bmetk/IoT-Based-Industrial-Data-Collection_2026/3D-Models_Inherited/misc/mlx90614-module-2.snapshot.2/MLX90164_Option_Code_Zoom_Optimized.jpg

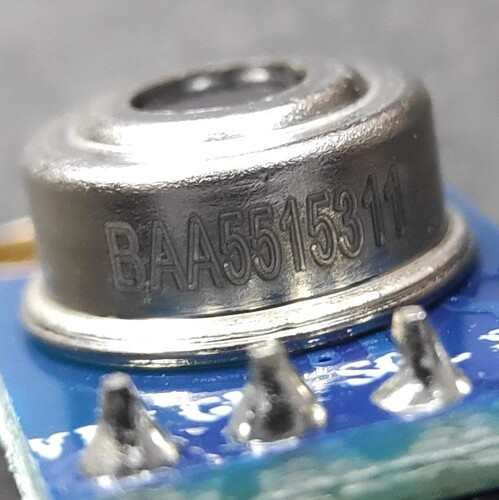
3D-Models_Inherited/misc/mlx90614-module-2.snapshot.2/MLX90164_Option_Code_Zoom_Optimized.jpg
