bmetk/IoT-Based-Industrial-Data-Collection_2026/README.md

# COMPACT-MAPS
Machine Analizator and Processor System
