bmetk/IoT-Based-Industrial-Data-Collection_2026/ESP_portkiosztasok.pdf

## ESP1 portkiosztása

ESP1 PORT | IR OPTO PORT
Bal felső 3V3 | IR opto VCC
Jobb felső GND | IR opto GND
GPIO 36 | IR opto OUT
ESP1 PORT | HŐMÉRŐ
Bal felső 3V3 | MLX VCC
Jobb felső GND | MLX GND
SCL – GPIO 22 | MLX SCL (közös)
SDA – GPIO 21 | MLX SDA (közös)
ESP1 PORT | ÁRAMMÉRŐ
Bal felső 3V3 | PHASE VCC
Jobb felső GND | PHASE GND
GPIO 32 | PHASE1_PIN
GPIO 33 | PHASE2_PIN
GPIO 35 | PHASE3_PIN
GPIO 34 | OFFSET_PIN
ESP1 PORT | KIJELZŐ
Bal felső 3V3 | SSD VCC
Jobb felső GND | SSD GND
SCL – GPIO 22 | SSD SCL (közös)
SDA – GPIO 21 | SSD SDA (közös)
ESP1 PORT | KOMMUNIKÁCIÓ
GPIO 19 | NEXT_PIN (gomb)
GPIO 18 | ENTER_PIN (gomb)
GPIO 16 | SERIAL_DATA_SEND
GPIO 17 | SERIAL_DATA_RECEIVE

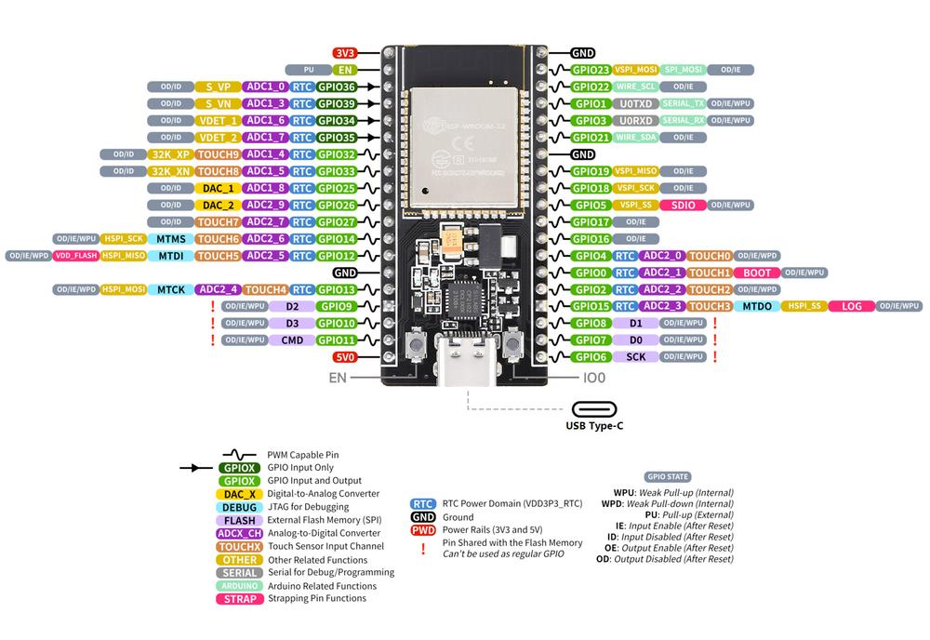
[picture p2: figure]

## ESP2 portkiosztása

ESP2 PORT | KOMMUNIKÁCIÓ
GPIO 17 | SERIAL_DATA_SEND
GPIO 16 | SERIAL_DATA_RECEIVE
ESP2 PORT | REZGÉSMÉRŐ
Bal felső 3V3 | MPU VCC
Jobb felső GND | MPU GND
SCL – GPIO 22 | MPU SCL
SDA – GPIO 21 | MPU SDA
GPIO 27 | MPU INT
