bmetk/IoT-Based-Industrial-Data-Collection_2026/3D-Models_Inherited/misc/mlx90614-module-2.snapshot.2/MLX90614XAA_Module_Angle_View_Bottom.jpg

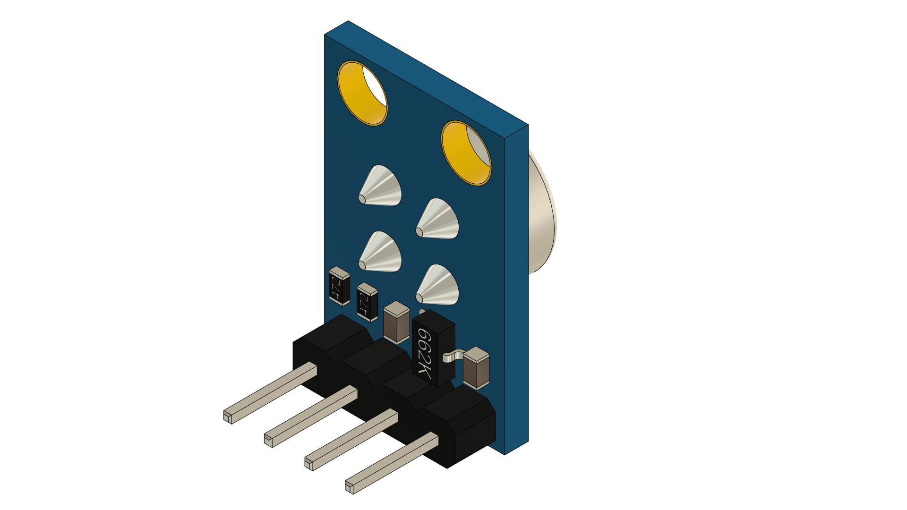
3D-Models_Inherited/misc/mlx90614-module-2.snapshot.2/MLX90614XAA_Module_Angle_View_Bottom.jpg
