bmetk/IoT-Based-Industrial-Data-Collection_2026/3D-Models_Inherited/3D printing/dust_cover.stl

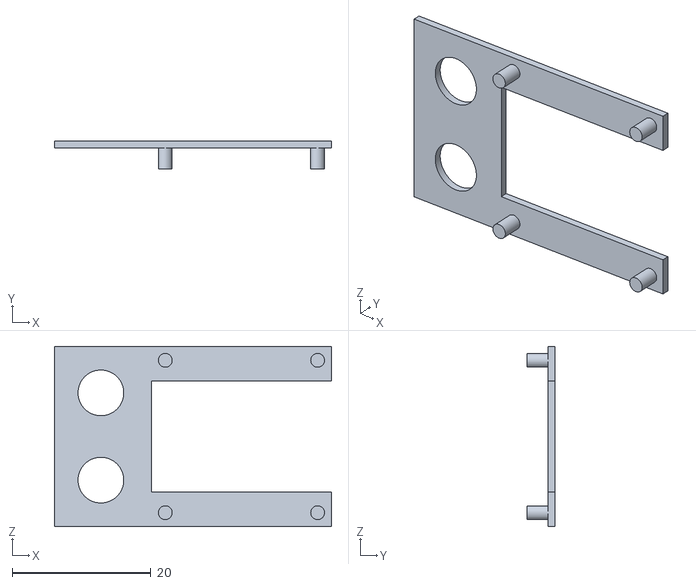
[picture p27: CAD file, 2026-06-04]
3D-Models_Inherited/3D printing/dust_cover.stl
40.0 x 4.00 x 26.0
