bmetk/IoT-Based-Industrial-Data-Collection_2026/3D-Models_Inherited/current sensor/current_sensor_cover.stl

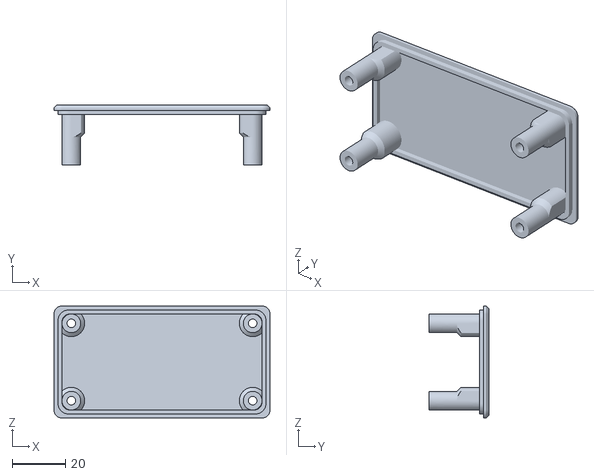
[picture p28: CAD file, 2026-05-20]
3D-Models_Inherited/current sensor/current_sensor_cover.stl
81.0 x 22.4 x 42.0
