bmetk/IoT-Based-Industrial-Data-Collection_2026/3D-Models_Inherited/EN3-01/disk_12_slot.stl

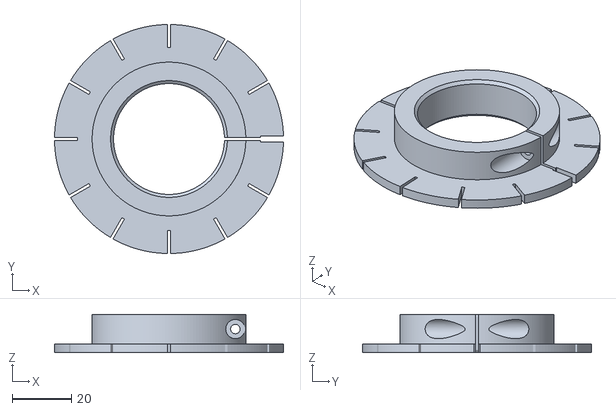
[picture p29: CAD file, 2026-06-04]
3D-Models_Inherited/EN3-01/disk_12_slot.stl
77.5 x 77.5 x 13.0
