bmetk/IoT-Based-Industrial-Data-Collection_2026/3D-Models_Inherited/housing/front_panel.stl

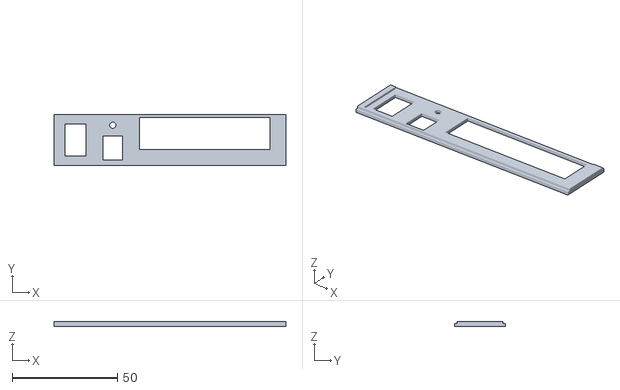
[picture p30: CAD file, 2026-06-04]
3D-Models_Inherited/housing/front_panel.stl
110.0 x 24.0 x 2.50
