bmetk/IoT-Based-Industrial-Data-Collection_2026/3D-Models_Inherited/housing/v_2/housing_top_v_2_2.stl

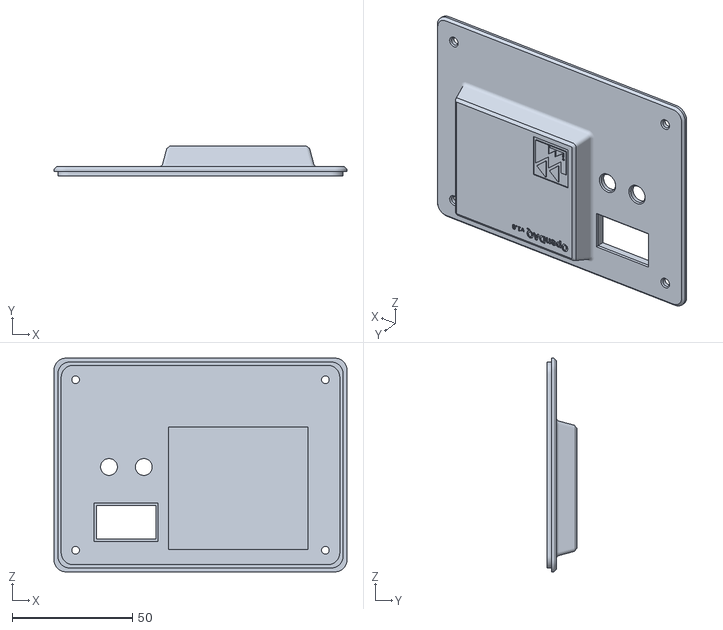
[picture p31: CAD file, 2026-06-04]
3D-Models_Inherited/housing/v_2/housing_top_v_2_2.stl
122.0 x 12.3 x 89.0
