bmetk/IoT-Based-Industrial-Data-Collection_2026/3D-Models_Inherited/misc/mlx_mount_4mm.stl

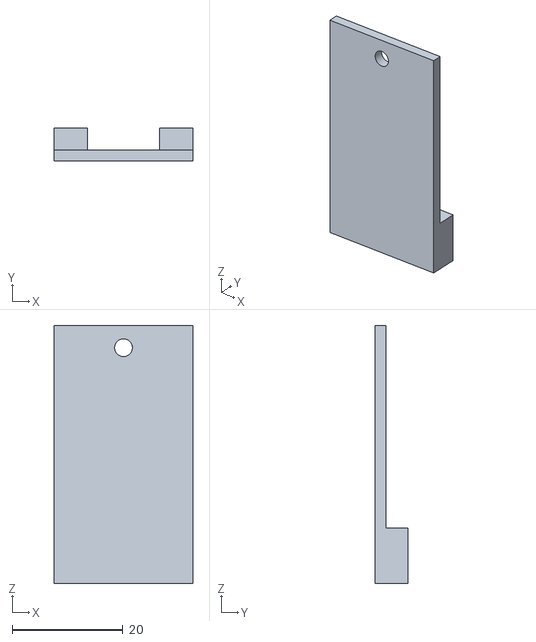
[picture p32: CAD file, 2026-06-04]
3D-Models_Inherited/misc/mlx_mount_4mm.stl
25.0 x 6.00 x 46.5
