bmetk/IoT-Based-Industrial-Data-Collection_2026/3D-Models_Reworked/housing_top_v_3 1.3mf

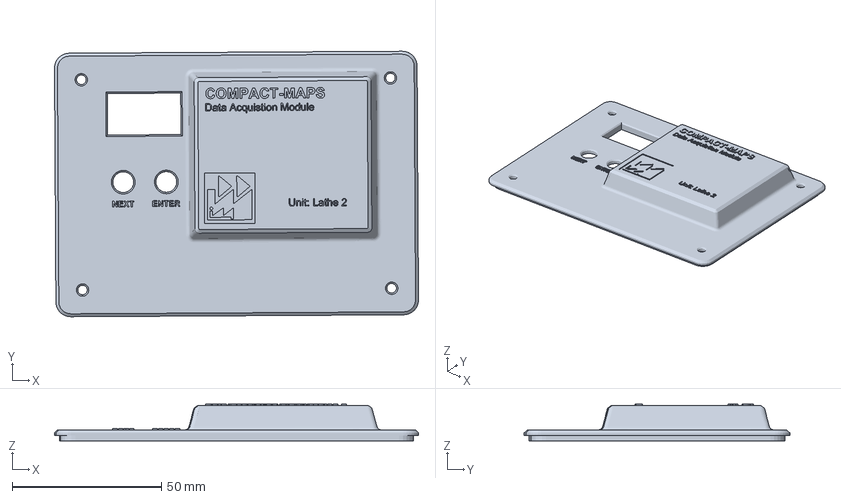
[picture p34: CAD file, 2026-05-20]
3D-Models_Reworked/housing_top_v_3 1.3mf
122.0 x 89.0 x 12.3 mm
