bmetk/IoT-Based-Industrial-Data-Collection_2026/Printed-Circuit-Boards_Inherited/resources/ZMCT103C/zmct103c.stp

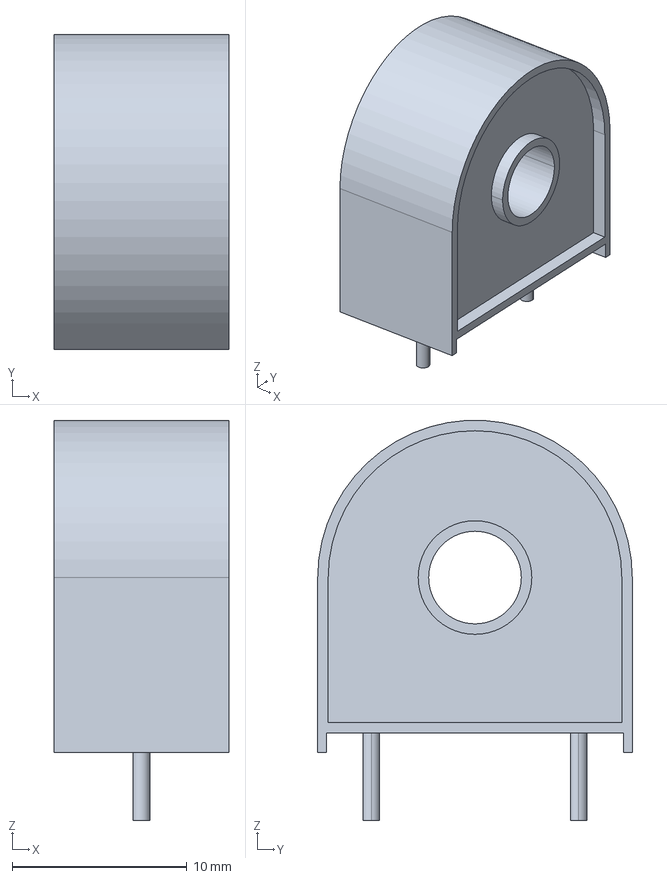
[picture p35: CAD file, 2026-06-04]
Printed-Circuit-Boards_Inherited/resources/ZMCT103C/zmct103c.stp
10.0 x 18.0 x 22.9 mm
