bmetk/IoT-Based-Industrial-Data-Collection_2026/Printed-Circuit-Boards_Inherited/zmct_3phase/zmct_3phase/zmct_3phase.step

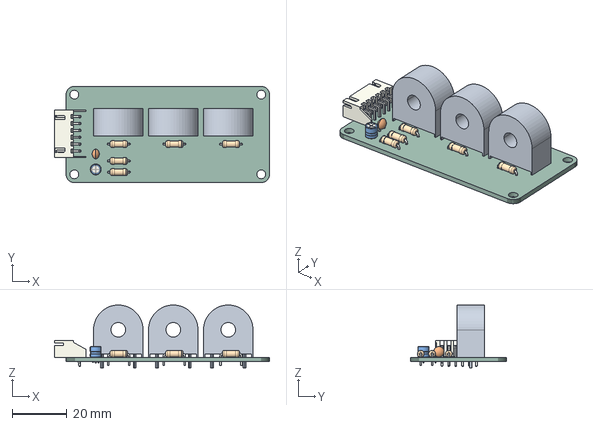
[picture p36: CAD file, 2026-06-04]
Printed-Circuit-Boards_Inherited/zmct_3phase/zmct_3phase/zmct_3phase.step
78.2 x 35.0 x 22.9 mm
zmct_3phase PCB
