bmetk/IoT-Based-Industrial-Data-Collection_2026/3D-Models_Inherited/3D printing/CE3PRO_display_base.3mf

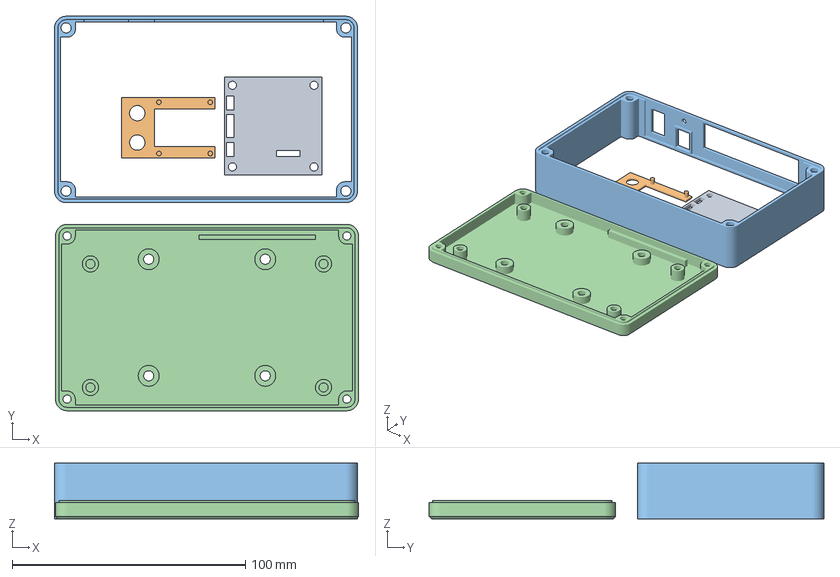
[picture p37: CAD file, 2026-06-04]
3D-Models_Inherited/3D printing/CE3PRO_display_base.3mf
130.4 x 169.3 x 24.0 mm
display_base.stl
dust_cover.stl
housing_side.stl
housing_bottom.stl
