bmetk/IoT-Based-Industrial-Data-Collection_2026/3D-Models_Inherited/current sensor/current_sensor_base.stl

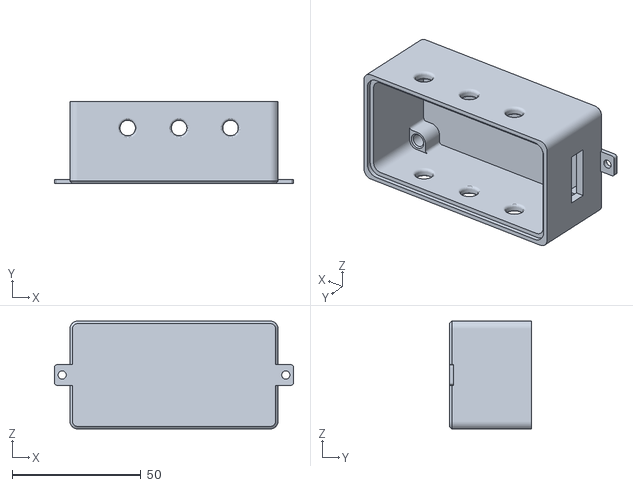
[picture p38: CAD file, 2026-05-20]
3D-Models_Inherited/current sensor/current_sensor_base.stl
93.0 x 32.0 x 42.0
