bmetk/IoT-Based-Industrial-Data-Collection_2026/3D-Models_Inherited/EN3-01/disk_6_slot_wide.stl

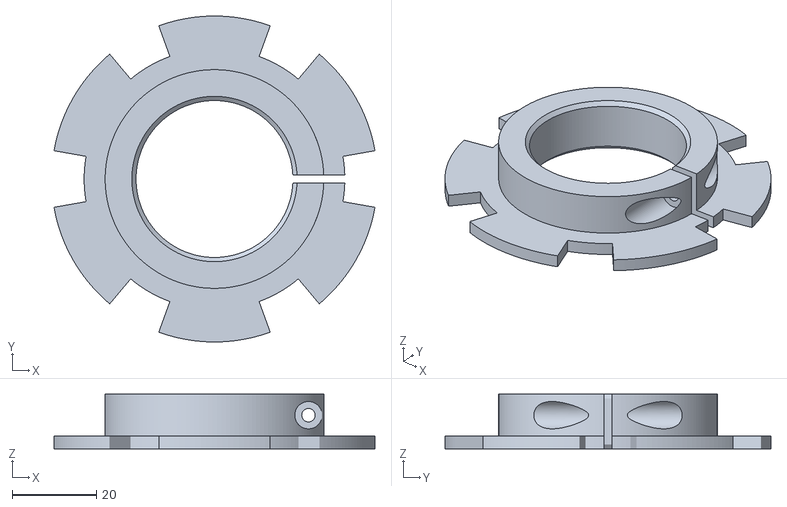
[picture p39: CAD file, 2026-06-04]
3D-Models_Inherited/EN3-01/disk_6_slot_wide.stl
76.3 x 77.5 x 13.0
