bmetk/IoT-Based-Industrial-Data-Collection_2026/3D-Models_Inherited/misc/mlx_mount_2mm.stl

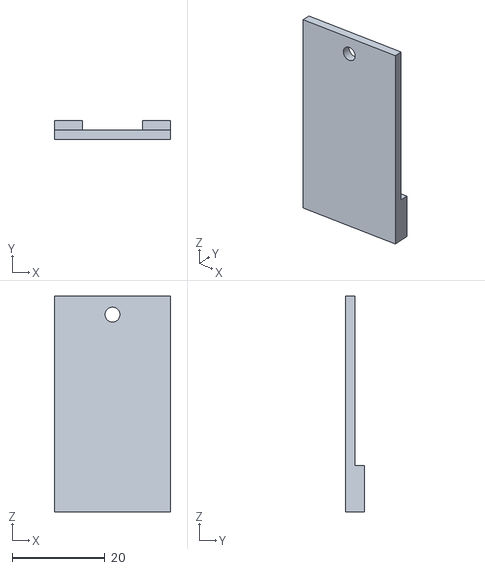
[picture p40: CAD file, 2026-06-04]
3D-Models_Inherited/misc/mlx_mount_2mm.stl
25.0 x 4.00 x 46.5
