bmetk/IoT-Based-Industrial-Data-Collection_2026/3D-Models_Inherited/3D printing/housing_side.stl

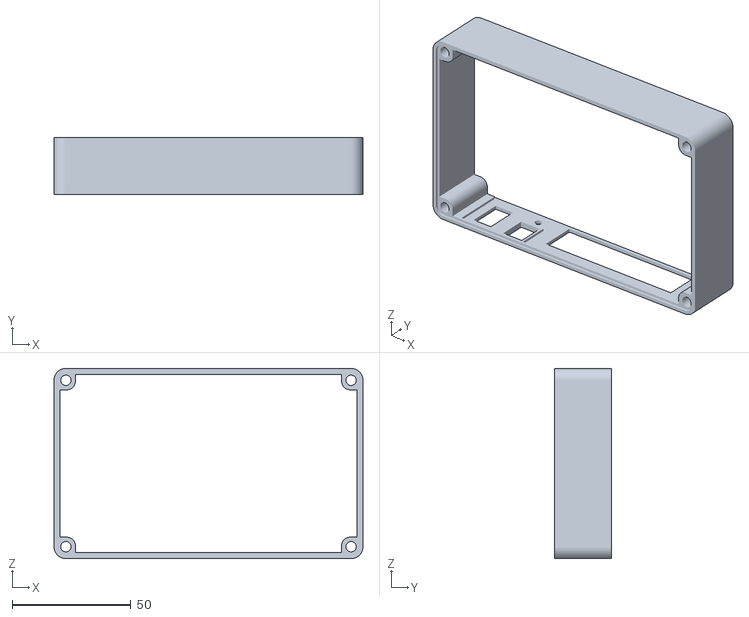
[picture p41: CAD file, 2026-06-04]
3D-Models_Inherited/3D printing/housing_side.stl
130.0 x 24.0 x 80.0
