bmetk/IoT-Based-Industrial-Data-Collection_2026/3D-Models_Inherited/EN3-01/sensor_adapter.stl

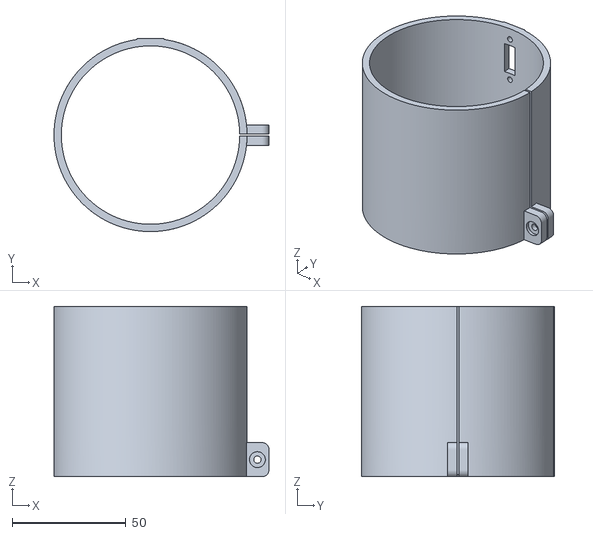
[picture p42: CAD file, 2026-06-04]
3D-Models_Inherited/EN3-01/sensor_adapter.stl
94.7 x 85.0 x 75.0
