bmetk/IoT-Based-Industrial-Data-Collection_2026/3D-Models_Inherited/housing/v_2/housing_base_v_2_sw.stl

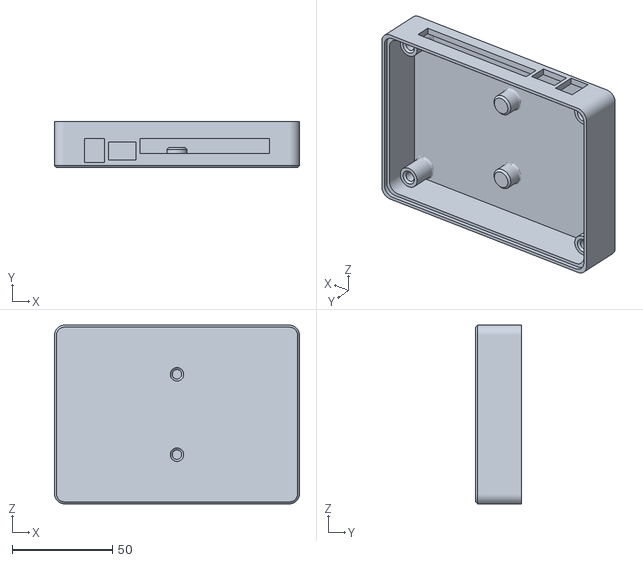
[picture p43: CAD file, 2026-06-04]
3D-Models_Inherited/housing/v_2/housing_base_v_2_sw.stl
122.0 x 23.0 x 89.0
