bmetk/IoT-Based-Industrial-Data-Collection_2026/3D-Models_Inherited/misc/mlx_holder.stl

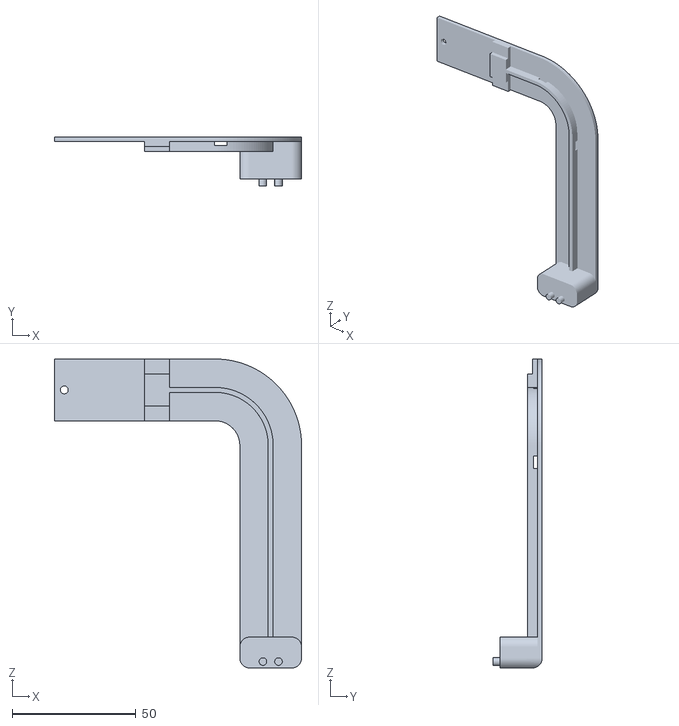
[picture p44: CAD file, 2026-06-04]
3D-Models_Inherited/misc/mlx_holder.stl
100.0 x 20.0 x 125.0
