bmetk/IoT-Based-Industrial-Data-Collection_2026/3D-Models_Inherited/3D printing/display_base.stl

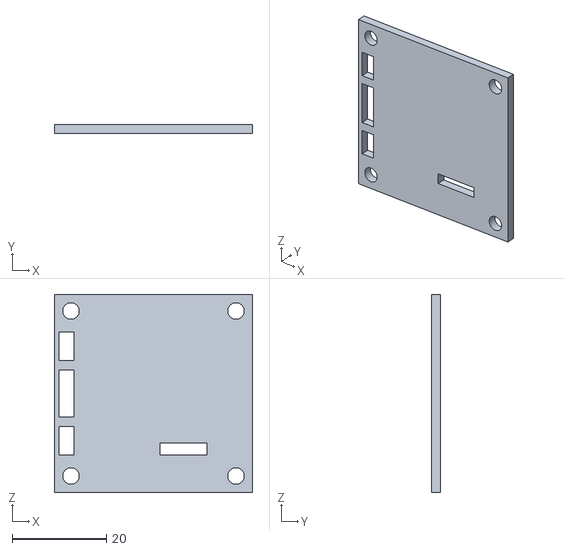
[picture p45: CAD file, 2026-06-04]
3D-Models_Inherited/3D printing/display_base.stl
42.0 x 2.00 x 42.0
