bmetk/IoT-Based-Industrial-Data-Collection_2026/3D-Models_Inherited/misc/mlx_mount_3mm.stl

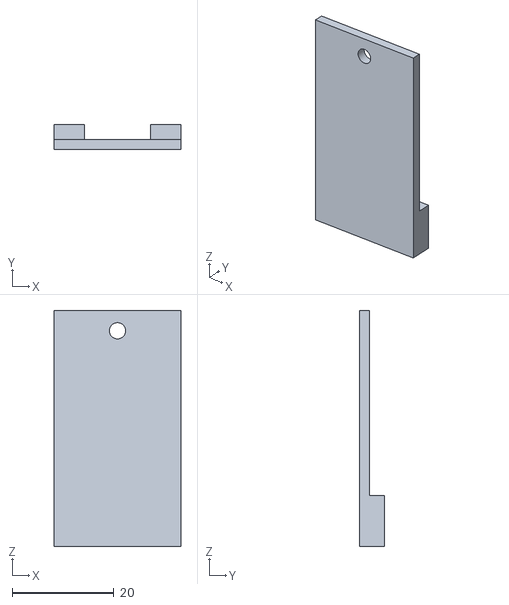
[picture p46: CAD file, 2026-06-04]
3D-Models_Inherited/misc/mlx_mount_3mm.stl
25.0 x 5.00 x 46.5
