bmetk/IoT-Based-Industrial-Data-Collection_2026/3D-Models_Inherited/3D printing/housing_bottom.stl

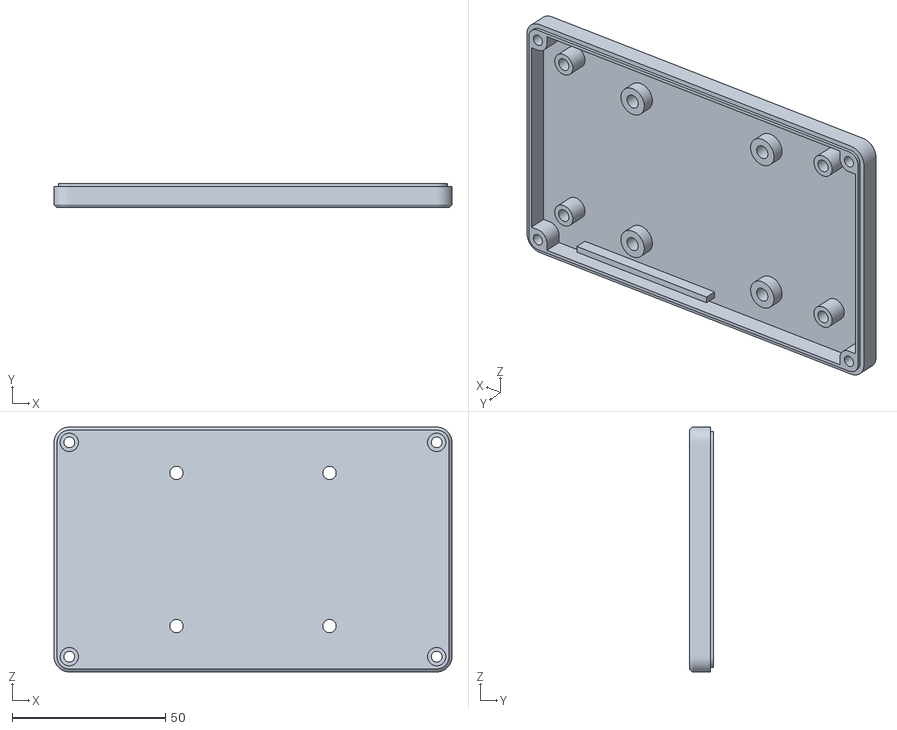
[picture p47: CAD file, 2026-06-04]
3D-Models_Inherited/3D printing/housing_bottom.stl
130.0 x 8.00 x 80.0
