bmetk/IoT-Based-Industrial-Data-Collection_2026/3D-Models_Inherited/misc/spacer_7.5mm.stl

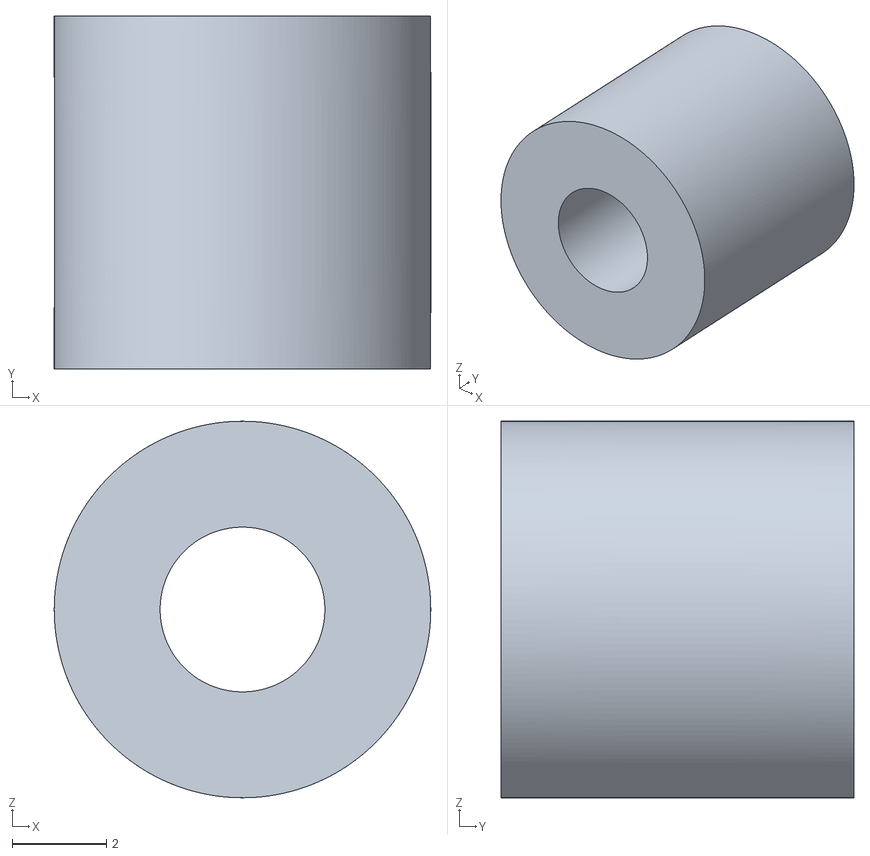
[picture p48: CAD file, 2026-06-04]
3D-Models_Inherited/misc/spacer_7.5mm.stl
8.00 x 7.50 x 8.00
