bmetk/IoT-Based-Industrial-Data-Collection_2026/3D-Models_Inherited/misc/panel_holder.stl

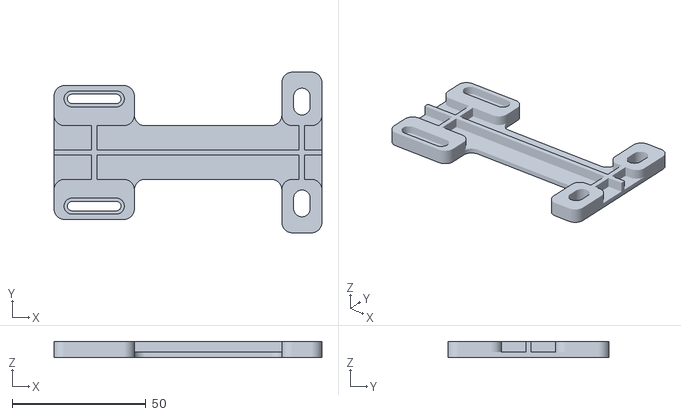
[picture p49: CAD file, 2026-06-04]
3D-Models_Inherited/misc/panel_holder.stl
100.0 x 60.0 x 6.00
