bmetk/IoT-Based-Industrial-Data-Collection_2026/(list of files, cad)

Other CAD files:
Printed-Circuit-Boards_Inherited/resources/ZMCT103C/zmct1037.stl
3D-Models_Inherited/EN3-01/disk_6_slot.stl
3D-Models_Inherited/housing/v_2/housing_base_v_2.stl
3D-Models_Inherited/EN3-01/Assembly2.iam
3D-Models_Inherited/EN3-01/OldVersions/Assembly2.0014.iam
3D-Models_Inherited/EN3-01/OldVersions/disk_12_slot.0005.ipt
3D-Models_Inherited/EN3-01/OldVersions/disk_6_slot.0002.ipt
3D-Models_Inherited/EN3-01/OldVersions/lathe_spindle_end.0003.ipt
3D-Models_Inherited/EN3-01/OldVersions/sensor_adapter.0011.ipt
3D-Models_Inherited/EN3-01/disk_12_slot.ipt
3D-Models_Inherited/EN3-01/disk_6_slot.ipt
3D-Models_Inherited/EN3-01/disk_6_slot_wide.ipt
3D-Models_Inherited/EN3-01/lathe_spindle_end.ipt
3D-Models_Inherited/EN3-01/sensor_adapter.ipt
3D-Models_Inherited/assembly/v_1/Assembly1.iam
3D-Models_Inherited/assembly/v_1/Assembly1_for_rendering.iam
3D-Models_Inherited/assembly/v_1/OldVersions/Assembly1.0022.iam
3D-Models_Inherited/assembly/v_2/OldVersions/assembly_v_2.0014.iam
3D-Models_Inherited/assembly/v_2/OldVersions/assembly_v_2_2.0005.iam
3D-Models_Inherited/assembly/v_2/assembly_v_2.iam
3D-Models_Inherited/assembly/v_2/assembly_v_2_2.iam
3D-Models_Inherited/current sensor/OldVersions/current_sensor.0008.iam
3D-Models_Inherited/current sensor/OldVersions/current_sensor_base.0012.ipt
3D-Models_Inherited/current sensor/OldVersions/current_sensor_cover.0008.ipt
3D-Models_Inherited/current sensor/current_sensor.iam
3D-Models_Inherited/current sensor/current_sensor_base.ipt
3D-Models_Inherited/current sensor/current_sensor_cover.ipt
3D-Models_Inherited/housing/v_1/OldVersions/dust_cover.0005.ipt
3D-Models_Inherited/housing/v_1/OldVersions/front_panel.0001.ipt
3D-Models_Inherited/housing/v_1/OldVersions/housing_base.0002.ipt
3D-Models_Inherited/housing/v_1/OldVersions/housing_bottom.0014.ipt
3D-Models_Inherited/housing/v_1/OldVersions/housing_side.0018.ipt
3D-Models_Inherited/housing/v_1/OldVersions/housing_top.0015.ipt
3D-Models_Inherited/housing/v_1/OldVersions/pcb_main_populated.0001.ipt
3D-Models_Inherited/housing/v_1/dust_cover.ipt
3D-Models_Inherited/housing/v_1/front_panel.ipt
3D-Models_Inherited/housing/v_1/housing_base.ipt
3D-Models_Inherited/housing/v_1/housing_bottom.ipt
3D-Models_Inherited/housing/v_1/housing_side.ipt
3D-Models_Inherited/housing/v_1/housing_top.ipt
3D-Models_Inherited/housing/v_2/OldVersions/housing_base_v_2.0012.ipt
3D-Models_Inherited/housing/v_2/OldVersions/housing_top_v_2.0008.ipt
3D-Models_Inherited/housing/v_2/OldVersions/housing_top_v_2_2.0011.ipt
3D-Models_Inherited/housing/v_2/housing_base_v_2.ipt
3D-Models_Inherited/housing/v_2/housing_top_v_2.ipt
3D-Models_Inherited/housing/v_2/housing_top_v_2.stl
3D-Models_Inherited/housing/v_2/housing_top_v_2_2.ipt
3D-Models_Inherited/misc/OldVersions/mlx_holder.0001.ipt
3D-Models_Inherited/misc/OldVersions/mlx_mount_2mm.0001.ipt
3D-Models_Inherited/misc/OldVersions/mlx_mount_3mm.0001.ipt
3D-Models_Inherited/misc/OldVersions/mlx_mount_4mm.0003.ipt
3D-Models_Inherited/misc/OldVersions/optocoupler.0002.ipt
3D-Models_Inherited/misc/OldVersions/panel_holder.0005.ipt
3D-Models_Inherited/misc/OldVersions/rocker_switch.0003.ipt
3D-Models_Inherited/misc/button_cap.ipt
3D-Models_Inherited/misc/mlx90614-module-2.snapshot.2/MLX90614XAA_Module.f3d
3D-Models_Inherited/misc/mlx90614-module-2.snapshot.2/MLX90614XAA_Module.step
3D-Models_Inherited/misc/mlx_holder.ipt
3D-Models_Inherited/misc/mlx_mount_2mm.ipt
3D-Models_Inherited/misc/mlx_mount_3mm.ipt
3D-Models_Inherited/misc/mlx_mount_4mm.ipt
3D-Models_Inherited/misc/mpu-9250-9dof-imu-1.snapshot.4/MPU-9250.iam
3D-Models_Inherited/misc/mpu-9250-9dof-imu-1.snapshot.4/MPU-9250_Shrinkwrap.ipt
3D-Models_Inherited/misc/optocoupler.ipt
3D-Models_Inherited/misc/panel_holder.ipt
3D-Models_Inherited/misc/rocker_switch.ipt
3D-Models_Inherited/misc/screws/din912/din_912-m3x0_5-10-8_8.ipt
3D-Models_Inherited/misc/screws/din912/din_912-m3x0_5-10-8_8.stp
3D-Models_Inherited/misc/spacer_7.5mm.ipt
3D-Models_Inherited/pcb/OldVersions/display_base.0001.ipt
3D-Models_Inherited/pcb/OldVersions/display_buttons.0009.ipt
3D-Models_Inherited/pcb/OldVersions/pcb_main_populated.0008.ipt
3D-Models_Inherited/pcb/OldVersions/ssd1360.0001.ipt
3D-Models_Inherited/pcb/display_base.ipt
3D-Models_Inherited/pcb/display_buttons.ipt
3D-Models_Inherited/pcb/pcb_main_populated.ipt
3D-Models_Inherited/pcb/ssd1306.ipt
3D-Models_Reworked/housing_top_v_3 1.stl
Printed-Circuit-Boards_Inherited/opendaq_carrier_1.0/BarrelJack_Wuerth_694108301002 (rev1).iam
Printed-Circuit-Boards_Inherited/opendaq_carrier_1.0/COMPOUND_1.ipt
Printed-Circuit-Boards_Inherited/opendaq_carrier_1.0/COMPOUND_2.ipt
Printed-Circuit-Boards_Inherited/opendaq_carrier_1.0/COMPOUND_3.ipt
Printed-Circuit-Boards_Inherited/opendaq_carrier_1.0/ESP32Wroom.iam
Printed-Circuit-Boards_Inherited/opendaq_carrier_1.0/JST_XH_B2B-XH-A_1x02_P2.50mm_Vertical.iam
Printed-Circuit-Boards_Inherited/opendaq_carrier_1.0/JST_XH_S3B-XH-A_1x03_P2.50mm_Horizontal.iam
Printed-Circuit-Boards_Inherited/opendaq_carrier_1.0/JST_XH_S4B-XH-A_1x04_P2.50mm_Horizontal.iam
Printed-Circuit-Boards_Inherited/opendaq_carrier_1.0/JST_XH_S5B-XH-A_1x05_P2.50mm_Horizontal.iam
Printed-Circuit-Boards_Inherited/opendaq_carrier_1.0/JST_XH_S6B-XH-A_1x06_P2.50mm_Horizontal.iam
Printed-Circuit-Boards_Inherited/opendaq_carrier_1.0/SOLID.ipt
Printed-Circuit-Boards_Inherited/opendaq_carrier_1.0/SOLID_1.ipt
Printed-Circuit-Boards_Inherited/opendaq_carrier_1.0/SOLID_2.ipt
Printed-Circuit-Boards_Inherited/opendaq_carrier_1.0/SOLID_3.ipt
Printed-Circuit-Boards_Inherited/opendaq_carrier_1.0/SOLID_4.ipt
Printed-Circuit-Boards_Inherited/opendaq_carrier_1.0/SOLID_5.ipt
Printed-Circuit-Boards_Inherited/opendaq_carrier_1.0/SSD1306_OLED_Display(128x64).iam
Printed-Circuit-Boards_Inherited/opendaq_carrier_1.0/Tactal Switch - THRU(12mmx12mmx8mm)-Black.iam
Printed-Circuit-Boards_Inherited/opendaq_carrier_1.0/kicad_module_3D_MINI560.iam
Printed-Circuit-Boards_Inherited/opendaq_carrier_1.0/opendaq_carrier_1.0 PCB.ipt
Printed-Circuit-Boards_Inherited/opendaq_carrier_1.0/opendaq_carrier_1.0.iam
Printed-Circuit-Boards_Inherited/resources/ZMCT103C/zmct103c.ipt
Printed-Circuit-Boards_Inherited/zmct_3phase/zmct_3phase/CP_Radial_D4.0mm_P2.00mm.iam
Printed-Circuit-Boards_Inherited/zmct_3phase/zmct_3phase/C_Disc_D3.8mm_W2.6mm_P2.50mm.iam
Printed-Circuit-Boards_Inherited/zmct_3phase/zmct_3phase/JST_XH_S6B-XH-A_1x06_P2.50mm_Horizontal.iam
Printed-Circuit-Boards_Inherited/zmct_3phase/zmct_3phase/R_Axial_DIN0207_L6.3mm_D2.5mm_P7.62mm_Horizontal.iam
Printed-Circuit-Boards_Inherited/zmct_3phase/zmct_3phase/SOLID.ipt
Printed-Circuit-Boards_Inherited/zmct_3phase/zmct_3phase/SOLID_1.ipt
Printed-Circuit-Boards_Inherited/zmct_3phase/zmct_3phase/SOLID_2.ipt
Printed-Circuit-Boards_Inherited/zmct_3phase/zmct_3phase/SOLID_3.ipt
Printed-Circuit-Boards_Inherited/zmct_3phase/zmct_3phase/SOLID_4.ipt
Printed-Circuit-Boards_Inherited/zmct_3phase/zmct_3phase/zmct103c.iam
Printed-Circuit-Boards_Inherited/zmct_3phase/zmct_3phase/zmct_3phase PCB.ipt
Printed-Circuit-Boards_Inherited/zmct_3phase/zmct_3phase/zmct_3phase.iam
