bmetk/IoT-Based-Industrial-Data-Collection_2026/Printed-Circuit-Boards_Inherited/resources/KiCad-SSD1306-128x64-master/README.md

# SSD1306 128x64 for kicad  

Kicad footprints and templates for [SSD1306 128x64px OLED Display*](https://amzn.to/2YUHoEB).



https://www.kicad.org

## SSD1306 as a component

You can use the SSD1306 as a module of a bigger kicad PCB project. 

### for eeschema
`library/SSD1306-128x64_OLED.lib` can be used as a component in your design.

To add it to eeschema:
* Preferences
* Components libraries
* add
* navigate to the `SSD1306-128x64_OLED.lib` file

### for pcbnew

`library/SSD1306.pretty` contains a footprint of the SSD1306 module for your PCB.

To add it to pcbnew:
* Preferences
* Footprint library manager
* Project Specific Libraries
* Append with Wizard
* navigate to `SSD1306.pretty`

### Further information may be found at https://ownsmarthome.de

_The links marked with an asterisk (*) are commission links or advertising._
