bmetk/IoT-Based-Industrial-Data-Collection_2026/Printed-Circuit-Boards_Inherited/zmct_3phase/zmct_3phase/zmct_3phase.kicad_pcb

## KiCad design Printed-Circuit-Boards_Inherited/zmct_3phase/zmct_3phase/zmct_3phase.kicad_pcb (2026-06-04)

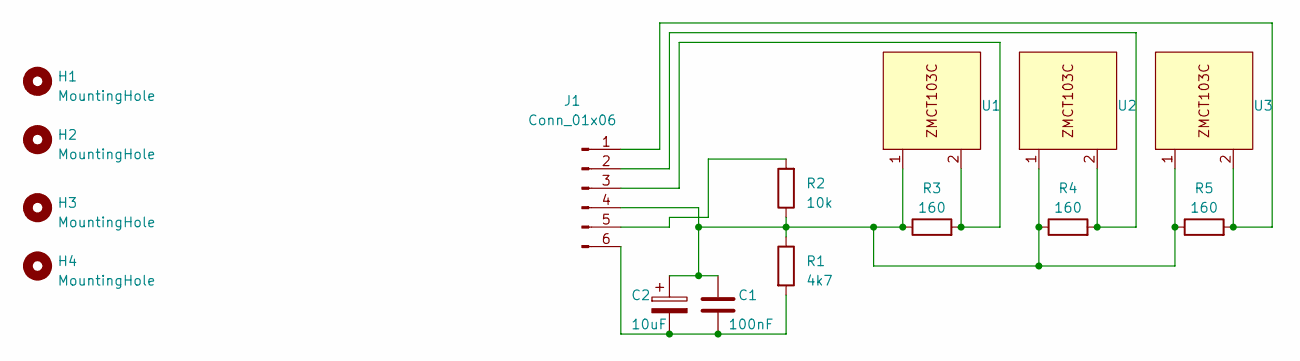
[picture p52: schematic zmct_3phase.kicad_sch]

Parts:
C1: 100nF; C_Disc_D3.8mm_W2.6mm_P2.50mm
C2: 10uF; CP_Radial_D4.0mm_P2.00mm
H1, H2, H3, H4: MountingHole; MountingHole_3.2mm_M3_DIN965_Pad
J1: Conn_01x06; JST_XH_S6B-XH-A_1x06_P2.50mm_Horizontal
R1: 4k7; R_Axial_DIN0207_L6.3mm_D2.5mm_P7.62mm_Horizontal
R2: 10k; R_Axial_DIN0207_L6.3mm_D2.5mm_P7.62mm_Horizontal
R3, R4, R5: 160; R_Axial_DIN0207_L6.3mm_D2.5mm_P7.62mm_Horizontal
U1, U2, U3: ZMCT103C

Connections:
unnamed: J1.1, R5.2, U3.2
unnamed: J1.2, R4.2, U2.2
unnamed: J1.3, R3.2, U1.2
unnamed: C1.1, C2.1, J1.4, R1.1, R2.1, R3.1, R4.1, R5.1, U1.1, U2.1, U3.1
unnamed: J1.5, R2.2
unnamed: C1.2, C2.2, J1.6, R1.2

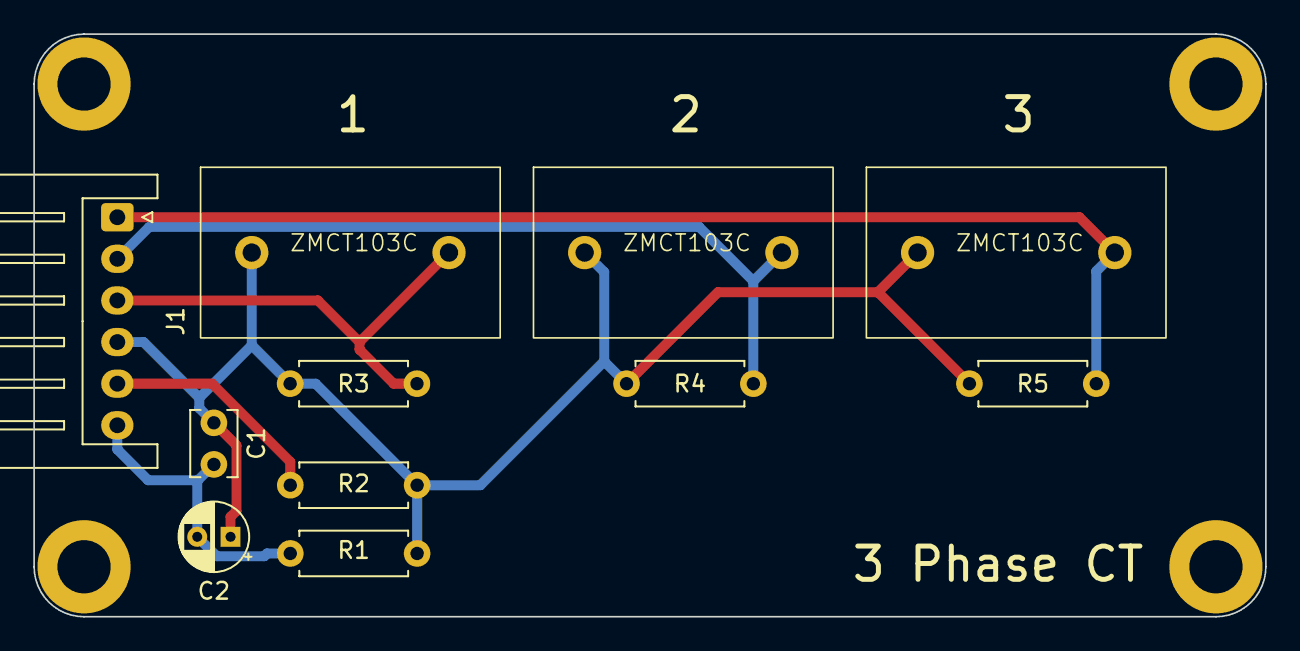
[picture p53: board zmct_3phase.kicad_pcb from above]

Board: 2 copper layers, 74.0 x 35.0 mm, 15 parts (0 on the bottom side), 6 nets.
