bmetk/IoT-Based-Industrial-Data-Collection_2026/g-epulet-twoesp32-lathe01/esp1/include/parameters.h

#ifndef PARAMETERS_H
#define PARAMETERS_H

#include <Arduino.h>

//PINOUTS
// menu.cpp - SSD1306 display 
#define DISP_ADDR 	0x3C
#define SCREEN_W 	128 // OLED width,  in pixels
#define SCREEN_H 	64 // OLED height, in pixels
#define ESP2_RESTART_PIN 5


// main.cpp - button and interrupt pins
#define NEXT_PIN 	19
#define ENTER_PIN 	18
#define DRDY_PIN 	27


// measurement.cpp - amp meter and optocoupler pins
#define OPTO_PIN 	36
#define PHASE1_PIN 	32
#define PHASE2_PIN 	33
#define PHASE3_PIN 	35
#define OFFSET_PIN 	34


//----------------
// TEXT PARAMETERS
//----------------
const int padding = 2; // padding in pixels
const int textSize = 1; // text size multiplier
const int textHeight = 7*textSize;
const int textWidth = 6*textSize;
const int headerHeight = textHeight + 3*padding;
const int offsetX = SCREEN_W/3;
const int offsetY = textHeight + textSize;


// BITMAP logo - Currently not shown
#define BMETK_WIDTH  65
#define BMETK_HEIGHT 64


static const unsigned char PROGMEM bmetk_bmp[] = {
    0x00, 0x00, 0xc0, 0x00, 0x00, 0x18, 0x00, 0x00, 0x00, 0x00, 0x00, 0xe0, 0x00, 0x00, 0x1c, 0x00, 
	0x00, 0x00, 0x00, 0x00, 0xf0, 0x00, 0x00, 0x1e, 0x00, 0x00, 0x00, 0x00, 0x00, 0xfc, 0x00, 0x00, 
	0x1f, 0x80, 0x00, 0x00, 0x00, 0x00, 0xfe, 0x00, 0x00, 0x1f, 0xc0, 0x00, 0x00, 0x00, 0x00, 0xff, 
	0x00, 0x00, 0x1f, 0xe0, 0x00, 0x00, 0x00, 0x00, 0xff, 0x80, 0x00, 0x1f, 0xf0, 0x00, 0x00, 0x00, 
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
	0xc3, 0xff, 0xff, 0xff, 0x80, 0xff, 0xff, 0xff, 0xff, 0xc3, 0xff, 0xff, 0xff, 0x80, 0xff, 0xff, 
	0xff, 0xff, 0xc3, 0xff, 0xff, 0xff, 0x80, 0xff, 0xff, 0xff, 0xff, 0xff, 0xff, 0xff, 0xff, 0x80
};


#endif
