bmetk/IoT-Based-Industrial-Data-Collection_2026/g-epulet-twoesp32-lathe01/esp1/src/connectivity.cpp

#include <Arduino.h>
#include <EspMQTTClient.h>
#include <credentials.h>
#include <HardwareSerial.h>

HardwareSerial SerialInterconn(2);

//------------------------
// Creating the ESP client
//------------------------
EspMQTTClient client {
  SSID,
  PWD,
  MQTT_ADDR,
  MQTT_USR,
  MQTT_PWD,
  "compactmaps1",
  MQTT_PORT
};

// Callback function for when the connection to the MQTT broker is established
void onConnectionEstablished(){
  Serial.println("ESP ONLINE");
}

// Function for clearing the serial buffer to avoid processing old messages
void clearSerialInterconn() {
  int x;
  while ((x = SerialInterconn.available()) > 0)
  {
     while (x--) SerialInterconn.read();
  }
}


//------------------------------------
// Initializing communication channels
//------------------------------------
void initCom(){
  // Configuring the client
  client.enableDebuggingMessages();
  client.setKeepAlive(10);
  client.setMaxPacketSize(20000);
  client.setMqttReconnectionAttemptDelay(10000);
  client.setWifiReconnectionAttemptDelay(10000);

  // Serial communication between Esps
  SerialInterconn.begin(115200, SERIAL_8N1, 16, 17);
  clearSerialInterconn();
}



bool checkClientCon(){
  return client.isConnected();
}
bool checkWifiCon(){
  return client.isWifiConnected();
}
void clientLoop() {
  client.loop();
}

// Function for sending MQTT messages to the broker
void sendMqttMessage(char* topic, const char* msg){
  client.publish(topic, msg);
}

// Sending commands to ESP2
void sendCommand(uint8_t cmd)
{
  uint8_t frame[3];

  frame[0] = 0xAA;
  frame[1] = cmd;
  frame[2] = cmd ^ 0xAA;

  SerialInterconn.write(frame, 3);
}

// Function for checking the serial messages received from ESP2
u_char checkSerialMessage() {
  if(SerialInterconn.available() > 0) {
    u_char msg = SerialInterconn.read();
    return msg;
  }
  else
    return 0;
}
