bmetk/IoT-Based-Industrial-Data-Collection_2026/(notices)

Notices in the files:
Printed-Circuit-Boards_Inherited/resources/KiCad-SSD1306-128x64-master/README.md:
License: CC BY-NC-SA 4.0
